bachlong12623/robo-desk/tools/faces_plead_sheet.png

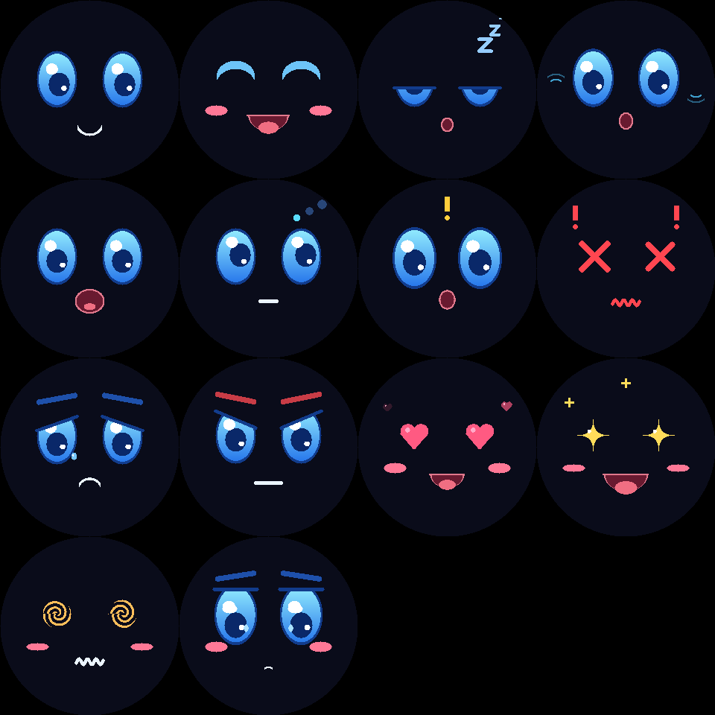
tools/faces_plead_sheet.png
