bachlong12623/robo-desk/tools/screens_sheet.png

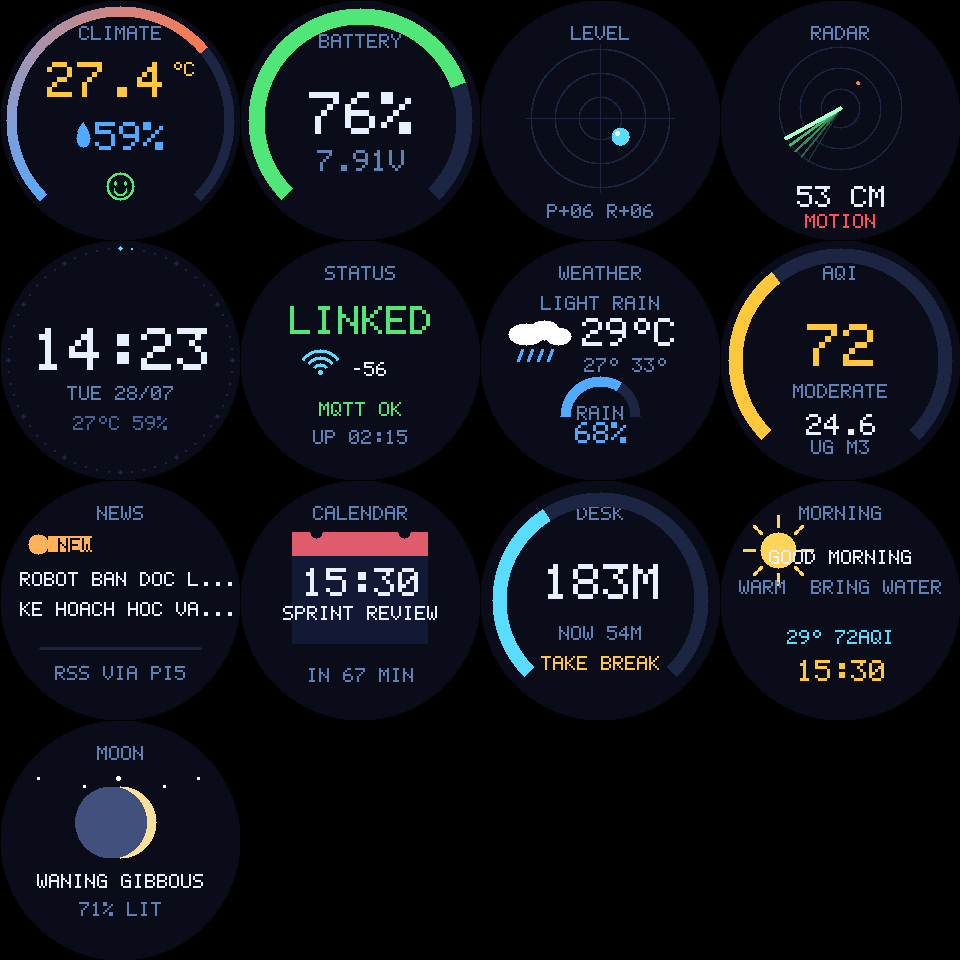
tools/screens_sheet.png
