bachlong12623/robo-desk/BOM.txt

# RoboDesk — Bill of Materials (chốt)
# Robot 2WD ESP32-S3 Solo-first. Tất cả mục §1–§5 = ĐANG CÓ.

## 1. Khối Xử lý & Lưu trữ

ESP32-S3 Dev Kit N16R8                          x1

## 2. Khối Năng lượng (2S)

Pin Lithium 18650 (2000mAh)                     x2
Đế pin 18650 đôi (nối tiếp 2S)                  x1
Mạch sạc 2S Type-C (BM1 cân bằng, KHÔNG bảo vệ xả) x1
Mạch hạ áp Buck DC-DC MP1584EN (chỉnh 5.0V)     x1
Công tắc gạt (ngắt nguồn chống xả cạn)          x1

## 3. Khối Giao tiếp Nghe/Nhìn

Màn hình LCD tròn 1.28" GC9A01 (SPI)            x1
Micro INMP441 (I2S)                             x1
Mạch Amply MAX98357A (I2S)                      x1
Củ loa 3W                                       x1
Vòng đèn LED RGB NeoPixel WS2812                x1

## 4. Khối Truyền động & Khung gầm

Động cơ giảm tốc N20 (300 RPM)                  x2
Mạch Driver DRV8833                             x1
Bánh xe N20                                     x2
Gá bắt motor N20                                x2
Bánh xe mắt trâu                                x1

## 5. Hệ thống Cảm biến

Cảm biến hồng ngoại TCRT5000                    x2
Cảm biến Laser ToF VL53L0X                      x1
Cảm biến Radar X-band Rd-04                     x1
Cảm biến MPU6050                                x1
Cảm biến DHT20                                  x1

## Phụ kiện lắp ráp (khuyến nghị mua thêm)

Dây điện đa sắc + đầu cos/cáp JST               x1 bộ
Mỏ hàn + thiếc + flux                           x1 bộ
Tụ điện phân cực 470–1000µF / 10V (gần 5V rail)  x2
Tụ ceramic 100nF (decouple từng module)         x10
Điện trở chia áp 100kΩ + 33kΩ (đo pin → GPIO10) x1 bộ
Level shifter 3.3V→5V (WS2812 DATA)             x1
Cầu chì / polyfuse 2–3A (sau công tắc)          x1
Ốc M2/M3 + trụ nhựa + keo nóng/zip tie          x1 bộ

## Raspberry Pi 5 — Linked mode (tùy chọn, không bắt buộc)

Raspberry Pi 5 (4/8GB)                          x1
Nguồn Pi 5 27W                                  x1
microSD 64GB                                    x1
Case + active cooler                            x1
