bachlong12623/robo-desk/tools/wiring_diagram.html

# RoboDesk — Sơ đồ chân IO (ESP32 ↔ từng cổng module)

Sơ đồ dây chân Bảng netlist Mermaid Nguồn 2S

Bỏ chọn

Nguồn

I2C

SPI

I2S

Motor

GPIO

− 100% + | Cuộn / kéo sơ đồ · Hover dây hoặc chân để xem cặp nối · Click module

Bus | ESP32 (header) | ↔ | Module | Chân module | Ghi chú

## Tất cả kết nối chân
