bachlong12623/robo-desk/(commit log)

2026-07-28 Update BOM.txt to reflect current inventory status and clarify quantities for components A and D.
2026-07-28 Add face pixel rendering and display support for GC9A01
    - Introduced a new anime-style face renderer for the GC9A01 display, allowing for various moods and animations.
    - Added support for displaying information screens, including climate, battery status, and more.
    - Updated the README to include new documentation for face pixel rendering and usage instructions.
    - Enhanced the firmware with new files for display management and drawing primitives.
    - Implemented MQTT integration for screen data updates and mood handling.
    - Improved overall system stability and performance with new verification steps and error handling.
    [display_gc9a01.c, display_gc9a01.h, face_draw.c, face_draw.h, face_pixel.c, face_pixel.h, face_ui.c, face_ui.h]
2026-08-19 docs: cập nhật BOM theo danh sách linh kiện cuối cùng
    - Tổ chức lại thành 5 khối: xử lý, nguồn 2S, nghe/nhìn, truyền động, cảm biến
    - Cập nhật mạch sạc 2S (BM1, không bảo vệ xả) và công tắc gạt chống xả cạn
    - Động cơ N20 300 RPM; tách bánh xe và gá motor
    - Chuyển breadboard/dây DuPont sang mục phụ tùng tùy chọn
2026-08-19 docs: hướng dẫn hàn dây và mô phỏng Wokwi
    - Thêm docs/WOKWI.md: bảng nối dây thật ↔ Wokwi, nguồn 2S, checklist
    - Thêm tools/wokwi/diagram.json và sketch.ino smoke test (GPIO khớp board_pins.h)
    - Cập nhật README trỏ tới tài liệu Wokwi
2026-08-19 chore: loại bỏ Wokwi khỏi project
    - Xóa docs/WOKWI.md và tools/wokwi/
    - Gỡ tham chiếu Wokwi trong README
2026-08-19 docs: đồng bộ toàn project theo BOM mới + hướng dẫn đấu dây cho người mới
    - BOM.txt: 5 khối chính, gọn phụ kiện khuyến nghị, bỏ INA219
    - WIRING.md: hướng dẫn chi tiết tiếng Việt, sơ đồ mermaid/ASCII, xử lý sự cố
    - POWER/PINMAP/BRINGUP/README: cập nhật nguồn 2S, công tắc gạt, N20 300RPM
    - Gỡ INA219 khỏi board_pins.h và tài liệu
2026-08-19 docs: bảng nối dây chi tiết từng cổng module ↔ ESP32-S3
    - Thêm docs/WIRING_PINS.md: nhãn in trên từng mạch, số lỗ header DevKit
    - Liên kết từ WIRING.md, PINMAP.md, README
2026-08-19 feat: sơ đồ đấu dây HTML tương tác + prompt Gemini
    - tools/wiring_diagram.html: click module xem bảng chân, tab nguồn 2S
    - docs/GEMINI_WIRING_PROMPT.md: 4 prompt copy-paste cho AI vẽ poster
    - README: liên kết tài liệu đồ họa
2026-08-19 feat: nâng cấp sơ đồ IO chi tiết — netlist, Mermaid, dây chân từng GPIO
    - Mỗi dây hiện nhãn GPIO ↔ chân module (SDA, AIN1...)
    - ESP32 header J1/J3 với số lỗ, bảng netlist lọc/tìm
    - Tab Mermaid auto-generate theo bus I2C/SPI/I2S
    - Hover/click highlight cặp nối
